Orekaria/digital_thermostat/Bill_Of_Materials.pdf

## Bill Of Materials for Arduino Nano 3.x

Design Title | Arduino Nano 3.x

### Author Document Number Revision

Design Created | miércoles, 15 de diciembre de 2021
Design Last Modified miércoles, 15 de diciembre de 2021

### Total Parts In Design 27

0 Modules
Quantity | References | Value | Stock Code | Unit Cost
Sub-totals: | | | | €0,00
0 Capacitors
Quantity | References | Value | Stock Code | Unit Cost
Sub-totals: | | | | €0,00
14 Resistors
Quantity | References | Value | Stock Code | Unit Cost
2 | R1,R5 | 2.2k
2 | R2,R16 | 1k
7 | R6-R12 | 2.2K
1 | R13 | 10k
1 | R14 | 330
1 | R15 | 90k
Sub-totals: | | | | €0,00
2 Integrated Circuits
Quantity | References | Value | Stock Code | Unit Cost
1 | U2 | LF50CV
1 | U3 | LM35
Sub-totals: | | | | €0,00
1 Transistors
Quantity | References | Value | Stock Code | Unit Cost
1 | Q1 | C945
Sub-totals: | | | | €0,00
2 Diodes
Quantity | References | Value | Stock Code | Unit Cost
1 | D1 | HFA08TB60
1 | D2 | LED-GREEN
Sub-totals: | | | | €0,00
8 Miscellaneous
Quantity | References | Value | Stock Code | Unit Cost
1 | ARD1 | ARDUINO NANO R3
2 | BC56-12SRWA,BT1
1 | HEATER | 8V
1 | PROBE | CONN-SIL2
1 | RL1 | 5V
1 | RV1 | 10k
1 | V2 | 14V
Sub-totals: | | | | €0,00
Totals: | | | | €0,00

jueves, 16 de diciembre de 2021 13:58:05
