Orekaria/digital_thermostat/(list of files, drawings)

Other design files:
proteus/digital_thermostat.pdsprj
