Orekaria/digital_thermostat/(commit log)

2021-12-18 Bill of materials
2021-12-18 Add proteus project
    [proteusPCB.pdsprj, termostato_pcb_v21.pdsprj]
2021-12-19 Do not set an already set heater state
2021-12-19 Move CARRIAGE_RETURN
2021-12-19 Add REF voltage
2021-12-30 Rename project name
    [digital_thermostat.pdsprj, termostato_pcb_v21.pdsprj]
2021-12-30 Update the proteus project with the latest source code
    [digital_thermostat.pdsprj]
2021-12-30 Add the N-Mosfet alternative schematic
    [digital_thermostat.pdsprj]
2022-01-14 Better switch circuit
    - the probe is always read
    - the original value (with a tiny difference) is sent back to the heater
    - the resistance used for the base of the transistor is also used to switch the heater on
    [digital_thermostat.pdsprj]
2022-01-14 Update images
    [digital_thermostat.pdsprj]
